Thanos3G/TinyPurr/enclosure/README.md

# Enclosure

The STL files are still being edited. The current print was good enough for the
first demo, but it is not a finished snap-fit enclosure yet.
