Thanos3G/TinyPurr/(commit log)

2026-09-01 Update BOM
2026-09-01 make wiring clear
2026-09-02 Changed two bugs with battery display. 1. dips that came from amplifier current draws and 2. batteryPercent now reads what batteryVolts already set instead of sampling again, the filter was advancing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
    [battery.cpp, main.cpp]
